sufzoli/suf-electronics-tm001/Design/Documentation/PIC/TM001_Front_Finished.jpg

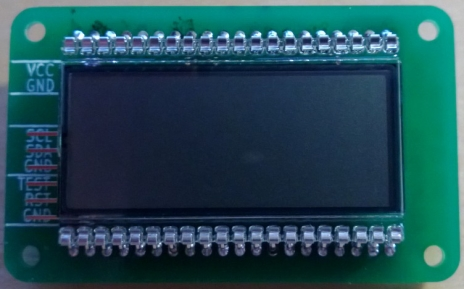
Design/Documentation/PIC/TM001_Front_Finished.jpg
