sufzoli/suf-electronics-tm001/Design/Documentation/PIC/TM001_Back.jpg

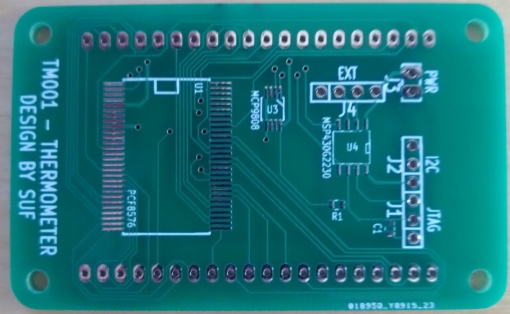
Design/Documentation/PIC/TM001_Back.jpg
