sufzoli/suf-electronics-tm001/README.md

suf-electronics-tm001
=====================

MSP430 Based Simple Thermometer
