sufzoli/suf-electronics-tm001/Design/Documentation/I2C Thermo Sensor Selection.xlsx

Sheet: Sheet1
Gyártó | Típus | Pontosság (szobahőmérsékleten) | Maximális Felbontás | Áramfelvétel (Működés közben) uA |  | Áramfelvétel (Alvó üzemmód) uA |  | Ár Net (HUF)
 |  |  |  | tipikus | maximum | tipikus | maximum
Texas Instruments | LM76 | +/- 1°C | 12 bit + előjel | 250 | 450 | 8 |  | 609.5 Ft | Farnell | 10db
Texas Instruments | LM92 | +/- 0,5°C | 12 bit + előjel | 350 | 625 | 5 |  | 769 Ft | Lomex | 10db
Texas Instruments | TMP112 | +/- 0,5°C | 12 bit | 10 |  | 1 |  | 696.5 Ft | Farnell | 10db
Analog Devices | ADT7420 | +/- 0,25°C | 16 bit | 210 | 265 | 2 | 15 | 1980.14 Ft | Farnell | 10db
Analog Devices | ADT7410 | +/- 0,5°C | 16 bit | 210 | 250 | 2 | 15 | 692.93 Ft | Farnell | 25db
Maxim Integrated | MAX31725 | +/- 0,5°C | 16 bit | 600 | 925 | 2.5 | 3.5 | 567 Ft | Mouser | 25db
Microchip | MCP9808E | +/- 0,25°C typ +/- 0,5°C max | 16 bit | 200 | 400 | 0.1 | 2 | 270 Ft | Chipcad | 1db

Sheet: Manufacturers
ATMEL
Energy Micro
ST Microelectronics
Texas Instruments
NXP
FreeScale
