sufzoli/suf-electronics-tm001/Design/Documentation/PIC/TempSensor.jpg

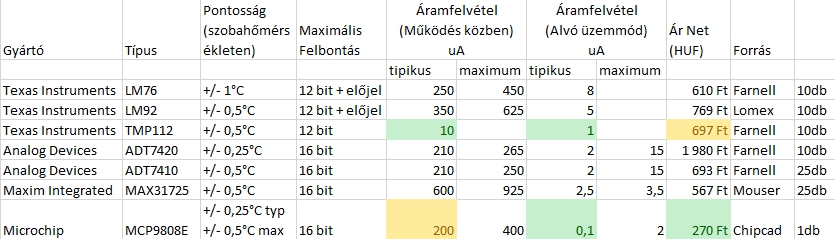
Design/Documentation/PIC/TempSensor.jpg
