sufzoli/suf-electronics-tm001/Design/Documentation/PIC/TM001_BreadBoard.jpg

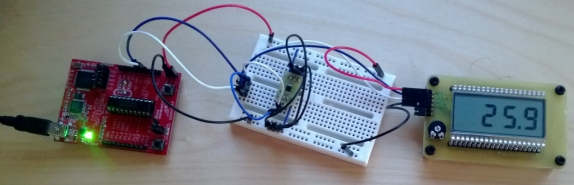
Design/Documentation/PIC/TM001_BreadBoard.jpg
