sufzoli/suf-electronics-tm001/Design/Documentation/PIC/TM001_Front.jpg

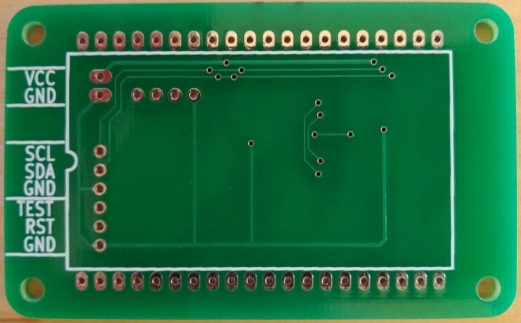
Design/Documentation/PIC/TM001_Front.jpg
