sufzoli/suf-electronics-tm001/Design/Documentation/PIC/TM001_HiRes.jpg

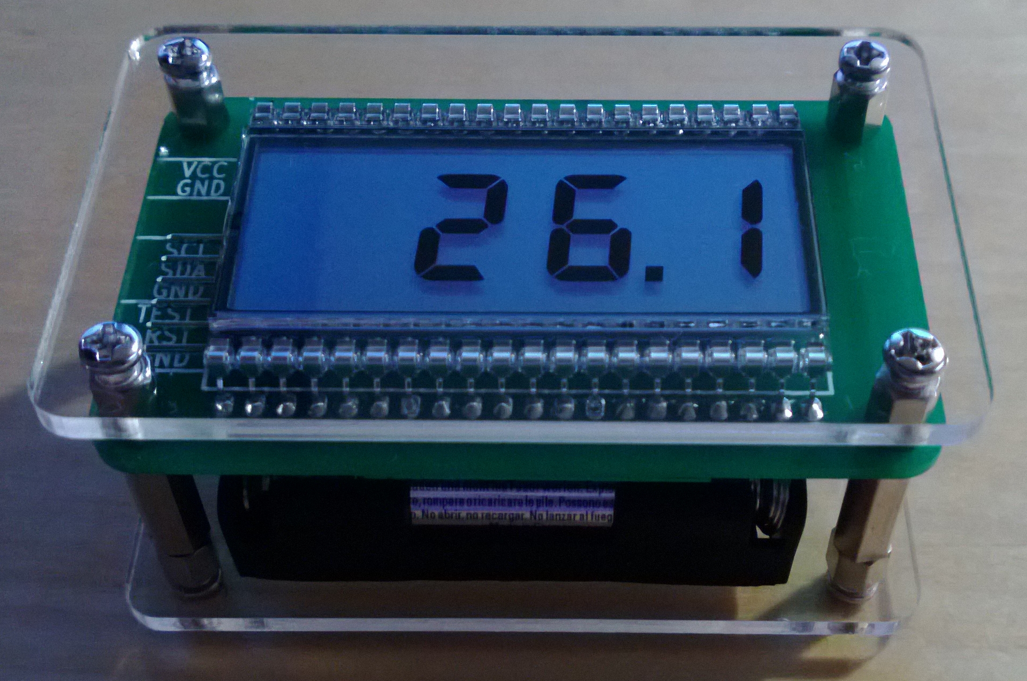
Design/Documentation/PIC/TM001_HiRes.jpg
