sufzoli/suf-electronics-tm001/Design/Documentation/PIC/TM001_HiRes_Wide.jpg

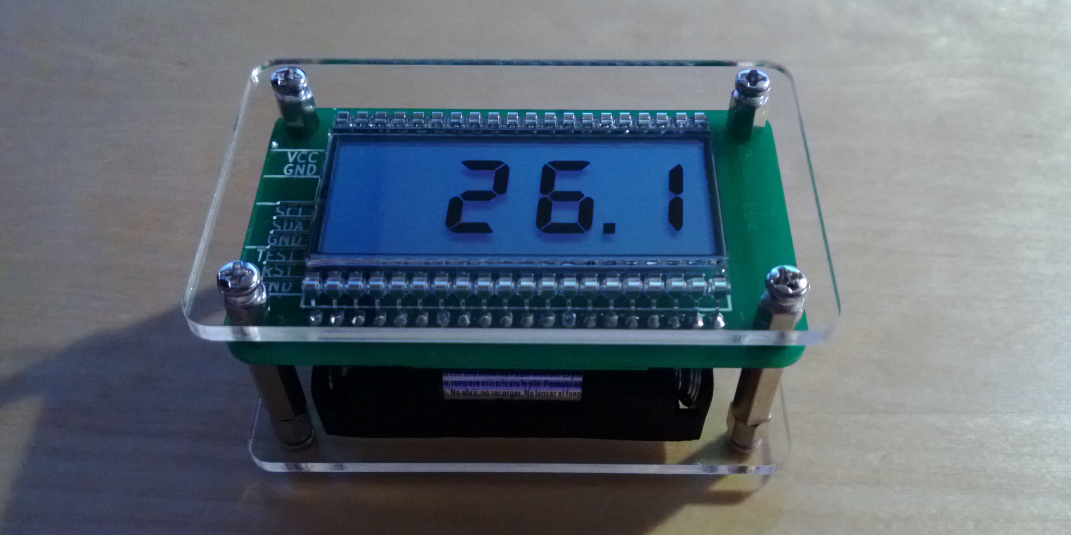
Design/Documentation/PIC/TM001_HiRes_Wide.jpg
