sufzoli/suf-electronics-tm001/Design/Documentation/PIC/TM001_PCB.jpg

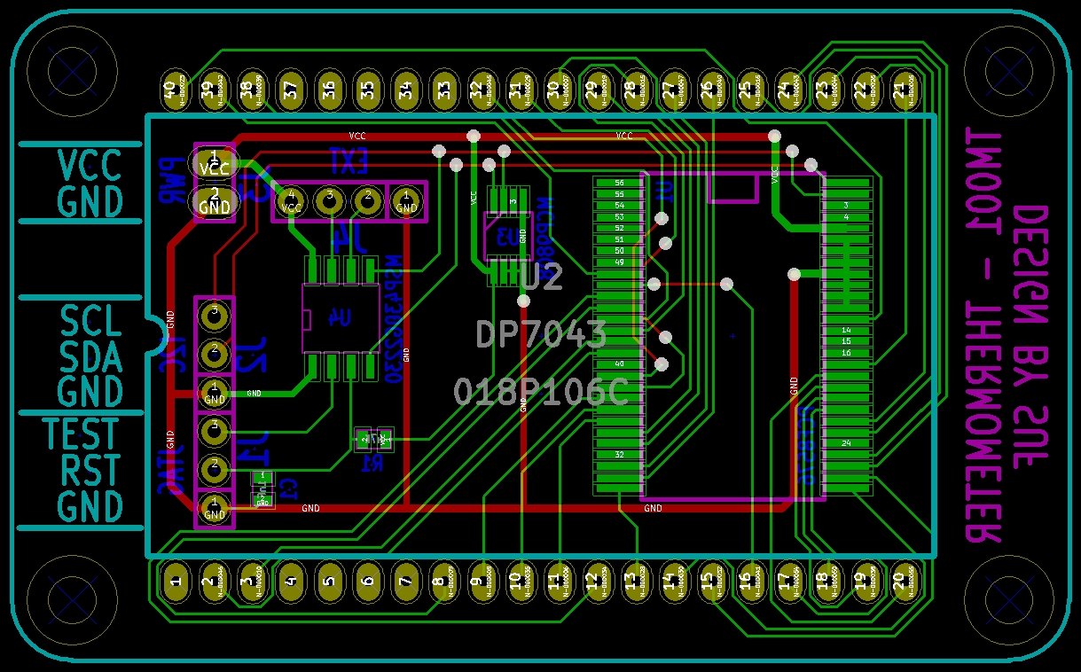
Design/Documentation/PIC/TM001_PCB.jpg
