sufzoli/suf-electronics-tm001/Design/Documentation/TM001_components.xlsx

Referencia | Érték | DB | Gyártó | Típus | Beszállító | Kód | Egységár | Ár
C1 | 1nF | 1 | Yageo | CC0603KRX7R9BB102 | Lomex | 82-02-39 | 6 | 6
J1-J2 | 6 pin tüskesor | 1 | T&T Connection | PHSR-40 | Lomex | 43-00-47 | 17 | 17
J3 | Elemtartó | 1 |  | BH2-AAA-1 | Lomex | 43-13-00 | 46 | 46
J4 | 4 pin tüskesor | 1 | T&T Connection | PHSS-40-6/3 | Lomex | 43-00-73 | 8 | 8
R1 | 47K | 1 | Viking | CR-03FL7---47K | Lomex | 80-11-72 | 5 | 5
U1 | PCF8576C | 1 | NXP | PCF8576CT/F1.112 | TME |  | 350 | 350
U2 | 018P106C | 1 | Displaytech | 018P106C | Lomex | 37-00-38 | 501 | 501
U3 | MCP9808 | 1 | Microchip | MCP9808-E/MS | Chipcad | MIC18426 | 343 | 343
U4 | MSP430G2230 | 1 | Texas Instruments | MSP430G2230ID | Farnell | 2148664 | 262 | 262
 |  |  |  |  |  |  |  | 1538
