sufzoli/suf-electronics-tm001/Design/Production/TM001.csv

ref | value
C1 | 1nF
J1 | JTAG
J2 | I2C
J3 | PWR
J4 | EXT
R1 | 47K
U1 | PCF8576
U2 | 018P106C
U3 | MCP9808
U4 | MSP430G2230
