sufzoli/suf-electronics-tm001/Design/Documentation/TM001_Schematics.pdf

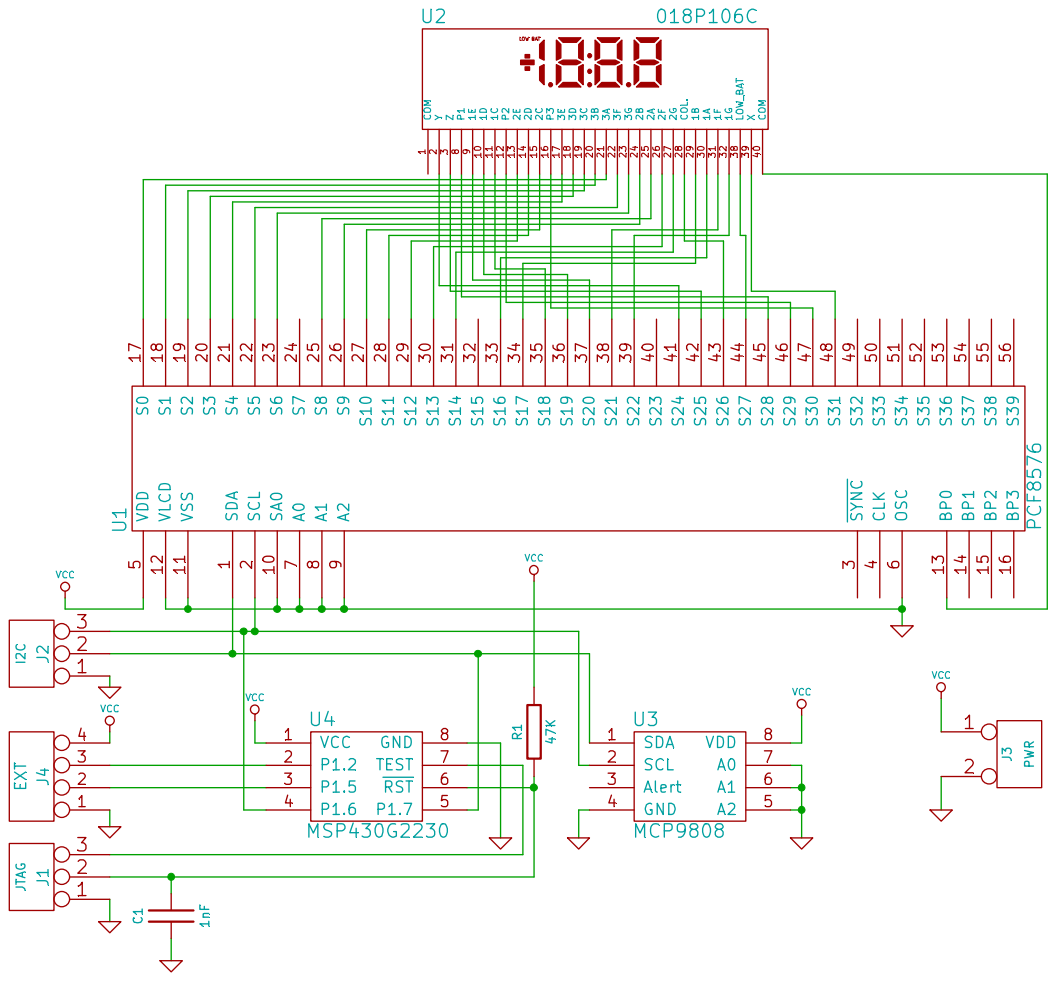
[picture p10: page 1]
