sufzoli/suf-electronics-tm001/Design/Production/TM001.sch

## KiCad design Design/Production/TM001.sch (2013-08-01)

Schematic: TM001.sch

Parts:
C1: 1nF; SM0603
J1: JTAG; SIL-3
J2: I2C; SIL-3
J3: PWR; SIL-2
J4: EXT; SIL-4
R1: 47K; SM0603
U1: PCF8576; VSO-56
U2: 018P106C; DIP-40_1275
U3: MCP9808; MSOP-8
U4: MSP430G2230; SOIC-8
